emlyon/makers-beehives-hardware/assets/git-clone-zip.png

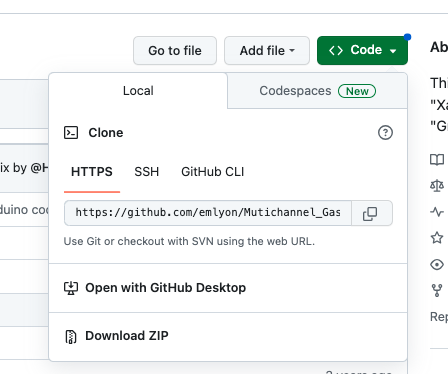
assets/git-clone-zip.png
