emlyon/makers-beehives-hardware/(threads)

Thread 5 (2023-06-30):

Gérer les erreurs de caméra PiCameraRuntimeError

Jetinho, 2023-06-30:
Par intermittence, on a l'erreur suivante :

PiCameraRuntimeError | Timed out waiting for capture to end

On veut éviter que ça annule le cycle de mesures entier à chaque fois.

1er essai de gestion : on retente le coup jusqu'à 3 fois.

Jetinho, 2023-06-30:
Résolu dans #6

Closed 2023-06-30.

Thread 11 (2023-07-06):

Gérer le fonctionnement hors-ligne des ruches

SeciLui, 2023-07-06:
<!--- Provide a general summary of the issue in the Title above -->

## Expected Behavior
<!--- Tell us what should happen -->
Lorsque la ruche n'est pas connectée à Internet, elle devrait toujours être capable de prendre des mesures et de les stocker localement jusqu'à ce qu'elle puisse les envoyer à la base de données une fois la connexion rétablie.

## Current Behavior
<!--- Tell us what happens instead of the expected behavior -->
Actuellement, si la ruche perd sa connexion Internet, elle cesse de prendre des mesures, ce qui peut entraîner la perte de données importantes sur l'activité de la ruche.

## Possible Solution
<!--- Not obligatory, but suggest a fix/reason for the bug, -->
Nous pourrions développer un mécanisme de stockage local pour les mesures prises en l'absence de connexion Internet. Ces données pourraient être mises en cache et envoyées à la base de données centrale une fois la connexion rétablie.

## Steps to Reproduce
<!--- Provide a link to a live example, or an unambiguous set of steps to -->
<!--- reproduce this bug. Include code to reproduce, if relevant -->
1. Déconnectez la ruche d'Internet.
2. Vérifiez si la ruche continue à prendre des mesures.
3. Si non, c'est le comportement actuel qui est en défaut.
4. Une fois la connexion rétablie, vérifiez si les mesures prises hors ligne sont synchronisées avec la base de données.

## Context (Environment)
<!--- How has this issue affected you? What are you trying to accomplish? -->
<!--- Providing context helps us come up with a solution that is most useful in the real world -->
Cette question est essentielle car les ruches peuvent ne pas toujours avoir une connexion Internet stable, en particulier dans des zones rurales éloignées. Il est essentiel de continuer à collecter des données pour surveiller l'activité de la ruche et la santé des abeilles, même en l'absence de connexion.

## Detailed Description
<!--- Provide a detailed description of the change or addition you are proposing -->
Proposer un système de collecte de données en mode déconnecté pour les ruches. Ce système permettrait de prendre des mesures même lorsque la ruche n'est pas connectée à Internet et de stocker ces mesures localement. Une fois la connexion rétablie, ces mesures seraient automatiquement synchronisées avec la base de données centrale.

## Possible Implementation
<!--- Not obligatory, but suggest an idea for implementing addition or change -->
On pourrait utiliser une mémoire flash pour stocker les mesures localement sur la ruche. Un script pourrait vérifier régulièrement si une connexion Internet est disponible. Si c'est le cas, il pourrait alors envoyer les mesures stockées localement à la base de données centrale et vider la mémoire flash.

Jetinho, 2023-07-06:
À gérer (à compléter) :

Quelles opérations effectuer en cas d'absence de connexion internet ?

- récupérer les données série de l'arduino.
- les stocker dans des fichiers JSON
- prendre les photos
- modification des images (resize, crop)
- génération du gif
- stockage du gif
- suppression des fichiers jpg.

Dans le cas où on récupère l'accès à internet, ils faut gérer la priorité des actions à mener :
- détecter qu'on est en mode "network recovery"
  - désactiver l'extinction automatique en fin de cycle
  - lancer un cycle de mesure
  - désactiver la coupure d'alimentation au bout de 10min via la trinket.
  - lancer l'upload des données

Jetinho, 2023-07-06:
@SeciLui super d'avoir renseigné toutes ces issues.
Tu disais tout à l'heure que tu as des solutions à proposer : n'hésite pas à envoyer et à me faire signe.
Je serai présent en pointillé demain mais je pourrai y jeter un oeil et on pourra surement déployer si c'est ok.

Thread 12 (2023-07-06):

Gestion correcte de l'extinction du Raspberry Pi pour prévenir les pertes de données

SeciLui, 2023-07-06:
<!--- Provide a general summary of the issue in the Title above -->

## Expected Behavior
<!--- Tell us what should happen -->
Le Raspberry Pi devrait être correctement éteint à la fin de chaque cycle pour éviter toute corruption ou perte de données.

## Current Behavior
<!--- Tell us what happens instead of the expected behavior -->
Actuellement, le courant est coupé sans que le Raspberry Pi ne soit correctement éteint, ce qui peut causer des pertes de données ou la corruption du système de fichiers.

## Possible Solution
<!--- Not obligatory, but suggest a fix/reason for the bug, -->
Il faudrait implémenter une routine d'extinction correcte pour le Raspberry Pi, afin de fermer correctement tous les processus et d'éviter la corruption de données.

## Steps to Reproduce
<!--- Provide a link to a live example, or an unambiguous set of steps to -->
<!--- reproduce this bug. Include code to reproduce, if relevant -->
1. Lancer un cycle de fonctionnement du Raspberry Pi.
2. A la fin du cycle, observer le processus d'extinction.
3. Si le courant est coupé sans extinction correcte du système, alors le comportement actuel est confirmé.

## Context (Environment)
<!--- How has this issue affected you? What are you trying to accomplish? -->
<!--- Providing context helps us come up with a solution that is most useful in the real world -->
Cette problématique est essentielle pour éviter la perte de données importantes et potentiellement la corruption du système de fichiers du Raspberry Pi. Une extinction incorrecte peut entraîner des problèmes de démarrage ultérieurs et compromettre le fonctionnement du dispositif.

## Detailed Description
<!--- Provide a detailed description of the change or addition you are proposing -->
Il est nécessaire d'intégrer une routine d'extinction correcte pour le Raspberry Pi. Cette routine permettrait d'arrêter correctement tous les processus en cours et de préparer le système pour une extinction en toute sécurité, évitant ainsi la perte de données et la corruption du système de fichiers.

## Possible Implementation
<!--- Not obligatory, but suggest an idea for implementing addition or change -->
Nous pourrions utiliser des scripts d'arrêt en Python ou en Bash pour arrêter correctement le système. Ces scripts devraient être exécutés à la fin de chaque cycle de fonctionnement avant que le courant ne soit coupé. Une autre option serait d'utiliser un circuit de contrôle d'alimentation matériel qui ne couperait le courant qu'après avoir reçu un signal indiquant que le Raspberry Pi a été correctement arrêté.

Thread 13 (2023-07-06):

Calibration du capteur de poids pour la gestion de l'ajout de hausses

SeciLui, 2023-07-06:
<!--- Provide a general summary of the issue in the Title above -->

## Expected Behavior
<!--- Tell us what should happen -->
Lorsqu'une hausse est ajoutée à la ruche, le capteur de poids devrait être capable de recalibrer son zéro pour tenir compte du nouveau poids total de la ruche (ruche originale plus hausse), sans effacer le poids précédemment mesuré.

## Current Behavior
<!--- Tell us what happens instead of the expected behavior -->
Actuellement, lorsqu'une hausse est ajoutée, le capteur de poids n'est pas recalibré pour prendre en compte le poids supplémentaire, ce qui peut fausser les mesures du poids du miel.

## Possible Solution
<!--- Not obligatory, but suggest a fix/reason for the bug, -->
Nous pourrions mettre en place une option dans l'interface permettant à l'apiculteur de signaler l'ajout d'une hausse. Lors de cette action, le système recalibrerait le capteur pour prendre en compte le nouveau poids total de la ruche sans remettre à zéro la mesure précédente.

## Steps to Reproduce
<!--- Provide a link to a live example, or an unambiguous set of steps to -->
<!--- reproduce this bug. Include code to reproduce, if relevant -->
1. Ajouter une hausse à une ruche déjà en fonction.
2. Observer les mesures du capteur de poids.
3. Si le poids mesuré n'est pas recalibré pour tenir compte du poids supplémentaire de la hausse, alors le comportement actuel est confirmé.

## Context (Environment)
<!--- How has this issue affected you? What are you trying to accomplish? -->
<!--- Providing context helps us come up with a solution that is most useful in the real world -->
L'ajout de hausses est une pratique courante en apiculture pour augmenter la production de miel. Un recalibrage précis du capteur de poids permettrait d'obtenir des mesures de poids de miel plus précises et donc d'optimiser la gestion de la production de miel.

## Detailed Description
<!--- Provide a detailed description of the change or addition you are proposing -->
Il est nécessaire d'implémenter une fonctionnalité permettant le recalibrage du capteur de poids lors de l'ajout d'une hausse à la ruche. Cette fonctionnalité permettrait de prendre en compte le poids supplémentaire de la hausse sans effacer la mesure précédente, permettant ainsi une mesure précise du poids du miel produit.

## Possible Implementation
<!--- Not obligatory, but suggest an idea for implementing addition or change -->
Une option pourrait être ajoutée à l'interface utilisateur pour indiquer l'ajout d'une hausse. Lorsque cette option est sélectionnée, une valeur de poids supplémentaire correspondant à la hausse est ajoutée à la mesure précédente du capteur de poids. Ainsi, le nouveau poids total de la ruche (ruche originale plus hausse) est pris en compte pour les mesures futures sans effacer le poids précédemment enregistré.

Thread 15 (2023-07-06):

Gérer le retour d'informations de l'Arduino lorsque les capteurs sont déconnectés ou défectueux tout en transmettant les données des capteurs fonctionnels

SeciLui, 2023-07-06:
<!--- Provide a general summary of the issue in the Title above -->

## Expected Behavior
<!--- Tell us what should happen -->
Lorsqu'un ou plusieurs capteurs sont déconnectés, mal branchés ou dysfonctionnels, l'Arduino devrait non seulement renvoyer une alerte ou un message d'erreur pour indiquer le problème, mais aussi continuer à transmettre les données des capteurs qui sont fonctionnels.

## Current Behavior
<!--- Tell us what happens instead of the expected behavior -->
Actuellement, si un ou plusieurs capteurs sont déconnectés, mal branchés ou défectueux, l'Arduino ne renvoie aucune donnée, ni message d'erreur, ce qui rend difficile la détection des problèmes.

## Possible Solution
<!--- Not obligatory, but suggest a fix/reason for the bug, -->
Il serait utile d'implémenter une fonction de vérification de l'état des capteurs dans le code Arduino. Cette fonction vérifierait régulièrement si tous les capteurs sont correctement connectés et fonctionnels, et renverrait une alerte ou un message d'erreur en cas de problème, tout en continuant à transmettre les données des capteurs qui sont fonctionnels.

## Steps to Reproduce
<!--- Provide a link to a live example, or an unambiguous set of steps to -->
<!--- reproduce this bug. Include code to reproduce, if relevant -->
1. Déconnectez ou mal branchez un capteur.
2. Observez le comportement de l'Arduino.
3. Si l'Arduino ne renvoie aucune donnée ou message d'erreur, alors le comportement actuel est confirmé.

## Context (Environment)
<!--- How has this issue affected you? What are you trying to accomplish? -->
<!--- Providing context helps us come up with a solution that is most useful in the real world -->
Cette question est cruciale pour la détection et la résolution des problèmes. L'absence d'alertes ou de messages d'erreur rend difficile la détection de capteurs déconnectés ou dysfonctionnels, ce qui peut compromettre l'efficacité du système et entraîner des pertes de données. De plus, même si certains capteurs sont défectueux, la transmission des données des capteurs fonctionnels reste essentielle pour maintenir une certaine utilité du système.

## Detailed Description
<!--- Provide a detailed description of the change or addition you are proposing -->
Il est nécessaire d'implémenter une fonction de vérification de l'état des capteurs dans le code Arduino. Cette fonction permettrait de détecter si un ou plusieurs capteurs sont déconnectés, mal branchés ou défectueux, et d'envoyer une alerte ou un message d'erreur en conséquence, tout en continuant à transmettre les données des capteurs qui sont fonctionnels.

## Possible Implementation
<!--- Not obligatory, but suggest an idea for implementing addition or change -->
L'Arduino pourrait implémenter une fonction "checkStatus" qui serait appelée à intervalles réguliers. Cette fonction vérifierait l'état de chaque capteur et, en cas de déconnexion ou de dysfonctionnement, renverrait un message d'erreur approprié, par exemple "Erreur : capteur de température

Closed 2023-07-12.

Thread 18 (2023-07-12):

Depuis la RPI, gérer les messages d'état des capteurs

Jetinho, 2023-07-12:
Avec la nouvelle version du code Arduino (cf. https://github.com/emlyon/makers-beehives-hardware/pull/17), la RPI ne parvient plus à lire les données correctement via la fonction `read_serial_data`

Voici le print qui tourne en boucle lorsqu'on lance un cycle :
```
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
```

Closed 2023-07-12.
