emlyon/makers-beehives-hardware/(commit log)

2018-09-28 Update trinketRelay.ino
    plus besoin de résistance qui tire en permanence avec les nouveaux battery pack
2019-04-02 fix index + proc in readme
    [beehives.py]
2019-04-03 update trinket code with deep sleep for Trinket 5v Pro
2019-04-04 Deep Sleep for Trinket Pro 5v
2019-05-27 add power refs
2019-06-05 move arduino code to its own folder + fix Serial speed + remove unused + coherent styleguide
    [arduino_beehive.ino]
2023-06-06 upload sensors data within sensors key
2023-06-14 fix C++ issue - missing `const`
    [arduino_beehive.ino]
2023-06-20 fix file path access from outside the folder. Read username instead of hostname
    [beehives.py]
2023-06-20 fix encoding issue reading serial input
    https://stackoverflow.com/questions/31529421/weird-output-value-bvalue-r-n-python-serial-read
    [beehives.py]
2023-06-20 avoid sending raw serial string to database
    [beehives.py]
2023-06-21 exit instead of shutting down the device
2023-06-21 avoid shutting down until we finalize the setup
    [beehives.py]
2023-06-28 fix error while writing serial string
    https://stackoverflow.com/questions/19877306/nameerror-global-name-unicode-is-not-defined-in-python-3
    https://stackoverflow.com/questions/35642855/python3-pyserial-typeerror-unicode-strings-are-not-supported-please-encode-to
    [beehives.py]
2023-06-28 fix data communication between arduino and pi
    [arduino_beehive.ino, beehives.py]
2023-06-30 retry taking picture after error.
    [beehives.py]
2023-07-05 7 : remove images at the en of a cycle (#9)
    * ensure images are created within the repository and then removed at the end of each cycle.
    * keep files at root level
    * ensure script is run from the repo directory
    * try to call rm command from os system
    * read current location
    * move to repository before pulling
    * remove images even if an error occured
    [beehives.py]
2023-07-10 enable sensor detection and operation even with sensor error.
    (code by @Heranel84)
    [arduino_beehive.ino]
2023-07-10 Add basic documentation for Arduino Uno setup
2023-07-11 fix typos and units
    [arduino_beehive.ino]
2023-07-12 ensure we wait for Arduino setup to be over before we ask data
2023-07-12 in case of error, print that error
    [beehives.py]
2023-07-12 Add low power library link
